ramalexiev/FireNet/BOMs/Updated Colective BOM.xlsx

Sheet: Main Platform - Revision 1
Comment | Designator | Quantity | Extras | Price per unit | Total Price
CR2450 | BAT1 | 1 | 1 | 1.25 | 2.5
CL21A475KACLRNC | C1, C24 | 2 | 3 | 0.35 | 1.75
885012106022 | C2, C7, C13, C14, C15 | 5 | 2 | 0.094 | 0.658
885012206046 | C3, C4, C5, C6, C8, C16, C17, C19, C21, C22, C23, C25, C26, C29, C30, C31, C32, C50 | 18 | 5 | 0.057 | 1.311
GQM1885C2A6R8CB01D | C9, C10 | 2 | 1 | 0.81 | 2.43
GRM1885C1H102JA01J | C12 | 1 | 1 | 0.14 | 0.28
DB-5R5D105T | C18 | 1 | 1 | 5.1 | 10.2
GRM21BR61E106MA73L | C11, C20, C27, C28 | 4 | 1 | 0.38 | 1.9
CC0805JRNPO0BN120 | C33, C34 | 2 | 1 | 0.21 | 0.63
GCM155R71E103KA37D | C35 | 1 | 1 | 0.14 | 0.28
GCM1555C1H470JA16D | C36, C40, C46 | 3 | 1 | 0.14 | 0.56
GCM155R71H102KA37D | C37, C47 | 2 | 1 | 0.15 | 0.45
GJM1555C1H1R2CB01D | C38 | 1 | 1 | 0.17 | 0.34
GCM1555C1H220JA16D | C39 | 1 | 1 | 0.15 | 0.3
GCM1555C1H8R2CA16D | C41, C42 | 2 | 1 | 0.17 | 0.51
GJM1555C1H3R3CB01D | C43, C44, C45, C48, C49 | 5 | 2 | 0.126 | 0.882
5003 | CLK_1, CLK_2, CS_1, CS_2, GND, MISO_1, MISO_2, MOSI_1, MOSI_2, S_VBAT1, SCL1, SDA1, TP2 | 13 | 3 | 0.475 | 7.6
NSP4201MR6T1G | D1 | 1 | 1 | 0.67 | 1.34
TLMO1000-GS08 | D2 | 1 | 1 | 0.79 | 1.58
APHD1608LCGCK | D3 | 1 | 1 | 0.65 | 1.3
TLMS1000-GS08 | D4, D5 | 2 | 1 | 0.74 | 2.22
PMEG2010ER,115 | D6, D7 | 2 | 1 | 0.54 | 1.62
ESDS312DBVR | D8 | 1 | 1 | 0.97 | 1.94
SSW-106-01-T-S | J1 | 1 | 1 | 0.92 | 1.84
1986775-6 | J2 | 1 | 5 | 4.17 | 25.02
5-1814832-1 | J3 | 1 | 5 | 2.82 | 16.92
MA5532 | L1 | 1 | 1 | 2.82 | 5.64 | Order from Mouser
LQW15AN33NJ00D | L2 | 1 | 1 | 0.26 | 0.52
LQW15AN2N7D00D | L3 | 1 | 1 | 0.26 | 0.52
LQW15AN5N6C10D | L4, L5 | 2 | 1 | 0.32 | 0.96
LQG15HS10NJ02D | L6 | 1 | 1 | 0.15 | 0.3
BSD 223P | Q1 | 1 | 1 | 0.67 | 1.34
NTJD5121NT1G | Q2 | 1 | 1 | 0.5 | 1
CRCW060333R0FKEAC | R1, R2, R3, R4, R5, R6, R7, R8, R11, R38 | 10 | 2 | 0.057 | 0.684
RC0603FR-0710KL | R9, R10, R18, R19, R32, R36 | 6 | 2 | 0.036 | 0.288
RC0603FR-0742K2L | R12 | 1 | 1 | 0.15 | 0.3
CR0603-FX-2003ELF | R13 | 1 | 1 | 0.15 | 0.3
RT0603FRE07220KL | R14 | 1 | 1 | 0.15 | 0.3
RC0603FR-07100KL | R15, R20, R23, R30, R31 | 5 | 2 | 0.036 | 0.252
ERJ-3EKF4701V | R16, R17 | 2 | 2 | 0.15 | 0.6
ERJ-3EKF9090V | R21, R22, R26 | 3 | 1 | 0.15 | 0.6
ERJ-3GEYJ132V | R24, R25, R28, R29, R34, R37 | 6 | 2 | 0.1 | 0.8
ERJ-3EKF6190V | R27 | 1 | 1 | 0.15 | 0.3
HRG3216Q-30R0-D-T1 | R33 | 1 | 1 | 1.46 | 2.92
RC0603FR-0720KL | R35 | 1 | 1 | 0.15 | 0.3
CRCW04020000Z0EDC | R39 | 1 | 1 | 0.15 | 0.3
ESR03EZPJ102 | R40 | 1 | 1 | 0.15 | 0.3
NTCG164KF104FTDS | RT1 | 1 | 1 | 0.43 | 0.86
STM32L433CCT6 | U1 | 1 | 1 | 8.83 | 17.66
AS3935 | U2 | 1 | 1 | 15.9 | 31.8
TS881ILT | U3 | 1 | 1 | 1.15 | 2.3
LM4120IM5-3.0/NOPB | U4 | 1 | 1 | 2.82 | 5.64
MAX9938WEUK+ | U5 | 1 | 1 | 2.28 | 4.56
MIC2041 | U6 | 1 | 1 | 1.93 | 3.86
SX1272IMLTRT | U7 | 1 | 1 | 11.41 | 22.82
MASWSS0166TR-3000 | U8 | 1 | 1 | 1.59 | 3.18
SF2098E | U9 | 1 | 1 | 1.84 | 3.68
NX3215SA-32.768K | Y1 | 1 | 1 | 1.03 | 2.06
ECS-320-10-30B-CKM-TR | Y2 | 1 | 1 | 0.94 | 1.88
971150611 | Standoff | 4 | 1
Totals: | Passives | 33.885 |  | Overall Price | 205.185
 | Special Components | 106.53 |  | Savings | 73.74
 | Ics | 129.75 |  | Paying Price | 131.445

Sheet: Sensor Board - Revision 1
Comment | Quantity | Extras | Price per Unit | Total Price | Designator
885012206046 | 3 | 2 | 0.057 | 0.285 | C1, C3, C4
885012106022 | 2 | 2 | 0.094 | 0.376 | C2, C5
CL21A475KACLRNC | 1 | 1 | 0.35 | 0.7 | C6
NSP4201MR6T1G | 1 | 0 | 0.67 | 0.67 | D1
5003 | 4 | 1 | 0.475 | 2.375 | GND1, S_SCL1, S_SDA1, VBAT1
T4111002041-000 | 1 | 4 | 5.39 | 26.95
T4141012041-000 | 1 | 4 | 8.58 | 42.9 | J1
NTJD5121NT1G | 1 | 1 | 0.53 | 1.06 | Q1
CRCW060333R0FKEAC | 2 | 1 | 0.15 | 0.45 | R1, R3
ERJ-3EKF4701V | 3 | 1 | 0.15 | 0.6 | R2, R4, R6
RC0603FR-0710KL | 1 | 1 | 0.15 | 0.3 | R5
SGP30 | 1 | 1 | 20.49 | 40.98 | U1
CCS811 | 1 | 3 | 19.44 | 77.76 | U2
BME280 | 1 | 1 | 11.81 | 23.62 | U3
AP2138N-1.8TRG1 | 1 | 1 | 0.53 | 1.06 | U4
 |  | Total Expected Price: |  |  | 220.086
 |  | Sponsorships: |  |  | 147.61
 |  | Removal of SGP30: |  |  | 44.15
 |  | Total Paying Price: |  |  | 28.326

Sheet: Total - Revision 1
Total Component expected costs: | 387.083
Total sponsorship savings: | 182.474
Total gas sensor savings: | 44.15
Total paying price: | 160.463
