ramalexiev/FireNet/BOMs/FireNet Pod - Altium.xlsx

Comment | Designator | Quantity
CL21A475KACLRNC | C1, C20 | 2
885012106022 | C2, C7, C13, C14, C15, C47, C50 | 7
885012206046 | C3, C4, C5, C6, C8, C16, C17, C18, C21, C22, C25, C26, C27, C28, C46, C48, C49 | 17
GQM1885C2A6R8CB01D | C9, C10, C29, C30 | 4
GRM21BR61E106MA73L | C11, C19, C23, C24 | 4
GRM1885C1H102JA01J | C12 | 1
GCM155R71H102KA37D | C31, C41 | 2
GCM1555C1H470JA16D | C32, C33, C39 | 3
GJM1555C1H3R3CB01D | C34, C35, C36, C37, C45 | 5
GCM155R71E103KA37D | C38 | 1
GJM1555C1H1R2CB01D | C40 | 1
GCM1555C1H220JA16D | C42 | 1
GCM1555C1H8R2CA16D | C43, C44 | 2
NSP4201MR6T1G | D1, D7 | 2
TLMO1000-GS08 | D2 | 1
APHD1608LCGCK | D3 | 1
TLMS1000-GS08 | D4, D5 | 2
DDZ3V6BSF-7DICT-ND | D6 | 1
SSW-106-01-T-S | J1 | 1
T4141012041-000 | J2 | 1
100uH | L1 | 1
LQG15HS10NJ02D | L2 | 1
LQW15AN33NJ00D | L3 | 1
LQW15AN2N7D00D | L4 | 1
LQW15AN5N6C10D | L5, L6 | 2
BSD 223P | Q1 | 1
NTJD5121NT1G | Q2, Q3 | 2
CRCW060333R0FKEAC | R1, R2, R3, R4, R5, R6, R7, R8, R11, R24, R25, R28, R29, R36, R40, R42 | 16
A126331CT-ND | R9, R10, R18, R19, R20, R23, R30, R31, R32, R34, R41, R43 | 12
RC0603FR-0742K2L | R12 | 1
CR0603-FX-2003ELF | R13 | 1
RT0603FRE07220KL | R14 | 1
ERA-3AEB104V | R15 | 1
ERJ-3EKF4701V | R16, R17 | 2
ERJ-3EKF9090V | R21, R22, R26 | 3
ERJ-3EKF6190V | R27 | 1
RC0603FR-0720KL | R33 | 1
ERJ-3GEYJ132V | R35 | 1
CRCW04020000Z0EDC | R37, R38 | 2
ESR03EZPJ102 | R39 | 1
NTCG164KF104FTDS | RT1 | 1
5003 | TP1, TP2, TP3, TP4, TP5, TP6, TP7, TP8, TP9, TP10, TP11, TP12, TP13, TP14, TP15, TP16, TP17, TP18, TP19, TP20, TP21, TP22 | 22
STM32L433CCT6 | U1 | 1
AS3935 | U2 | 1
TS881ILT | U3 | 1
LM4120IM5-3.0/NOPB | U4 | 1
MIC2041 | U5 | 1
SX1272IMLTRT | U6 | 1
PE4259-63 | U7 | 1
SGP30 | U8 | 1
BME280 | U9 | 1
AP2138N-1.8TRG1 | U10 | 1
NX3215SA-32.768K | Y1 | 1
FA-20H 32.0000MF12Y-W3 | Y2 | 1
