ramalexiev/FireNet/3D Parts/Mass-Damper-Block-Mass-With-Mounting-Holes.DXF

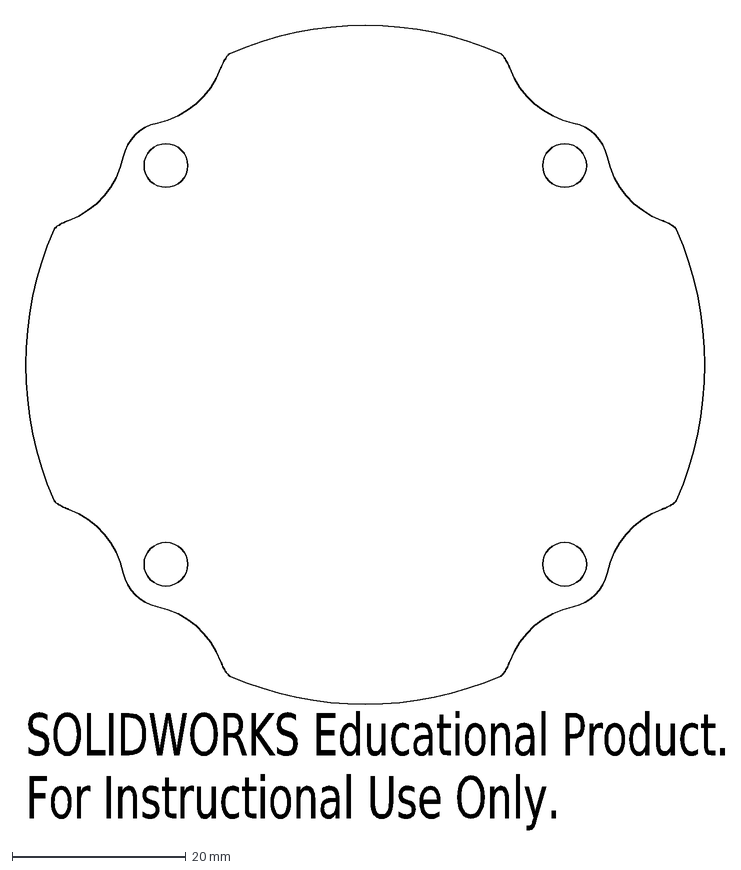
[picture p1: CAD file, 2019-02-22]
3D Parts/Mass-Damper-Block-Mass-With-Mounting-Holes.DXF
SOLIDWORKS Educational Product.
For Instructional Use Only.
