ramalexiev/FireNet/3D Parts/R1_Sensor Board - no fasteners.step

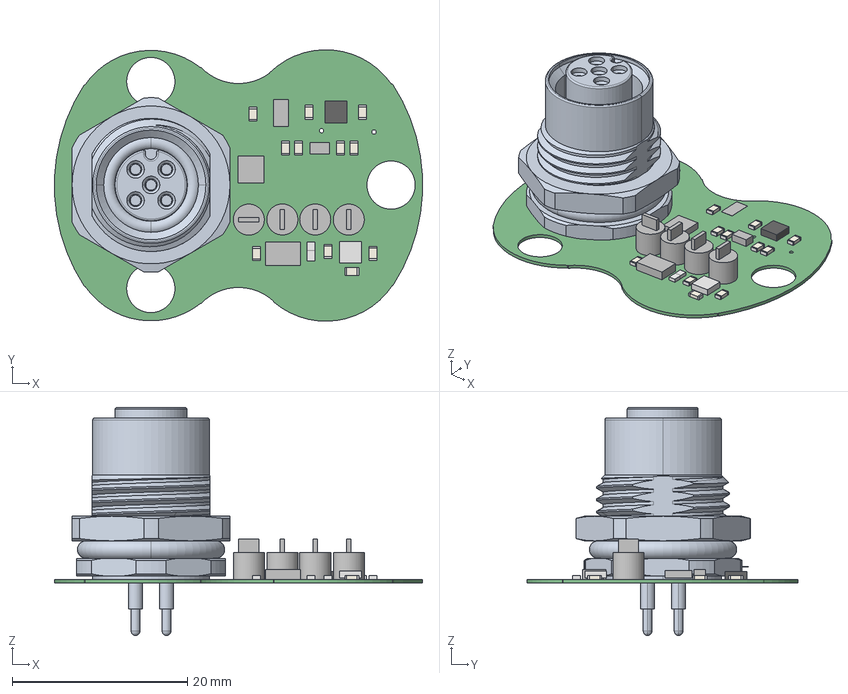
[picture p2: CAD file, 2019-02-22]
3D Parts/R1_Sensor Board - no fasteners.step
42.0 x 30.9 x 26.0 mm
B3
B2
B1
Extruded x 46
c-t4141012041-000-a-3d
