ramalexiev/FireNet/3D Parts/c-t4141012041-000-a-3d.stp

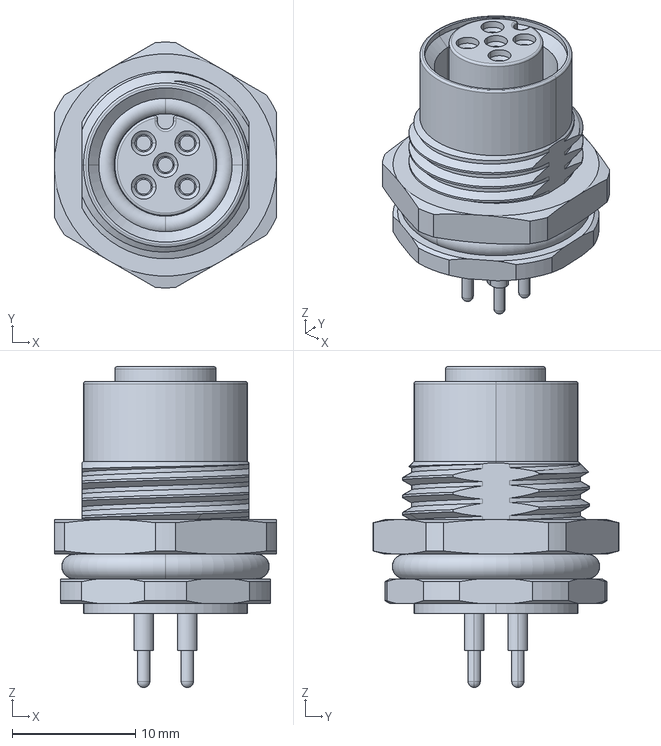
[picture p3: CAD file, 2019-02-22]
3D Parts/c-t4141012041-000-a-3d.stp
18.0 x 19.9 x 26.0 mm
