ramalexiev/FireNet/3D Parts/Space-Claim-Sensor-Board-With-Thru-Holes.STEP

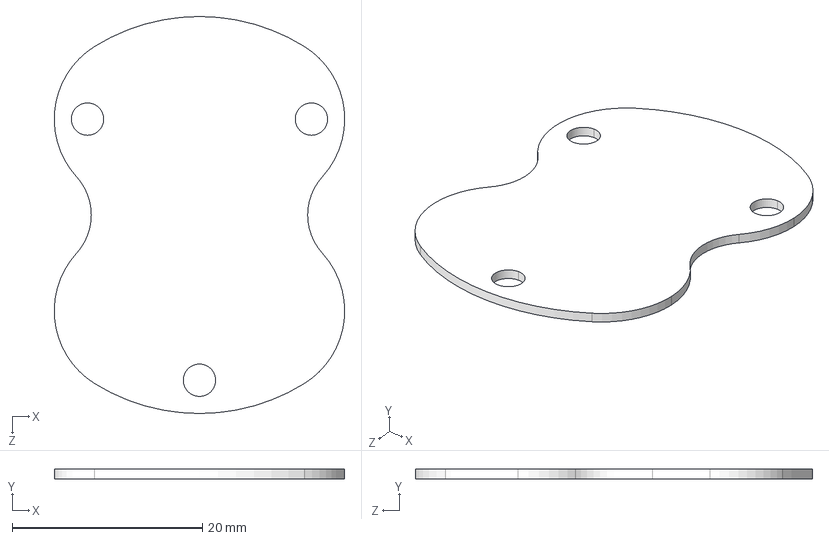
[picture p4: CAD file, 2019-02-22]
3D Parts/Space-Claim-Sensor-Board-With-Thru-Holes.STEP
30.5 x 1.00 x 41.8 mm
