ramalexiev/FireNet/3D Parts/Mass-Damper-Block-Mass-With-Mounting-Holes-2mm-Slice.STEP

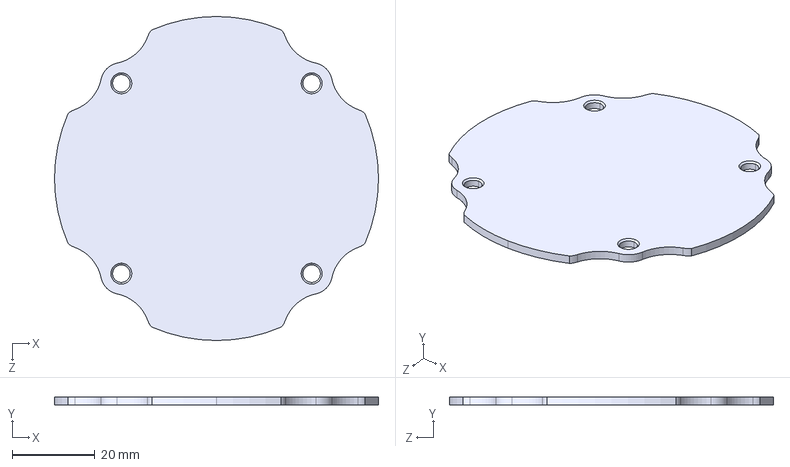
[picture p5: CAD file, 2019-02-22]
3D Parts/Mass-Damper-Block-Mass-With-Mounting-Holes-2mm-Slice.STEP
78.3 x 2.00 x 78.3 mm
