ramalexiev/FireNet/3D Parts/c-5-1814832-1-b-3d.stp

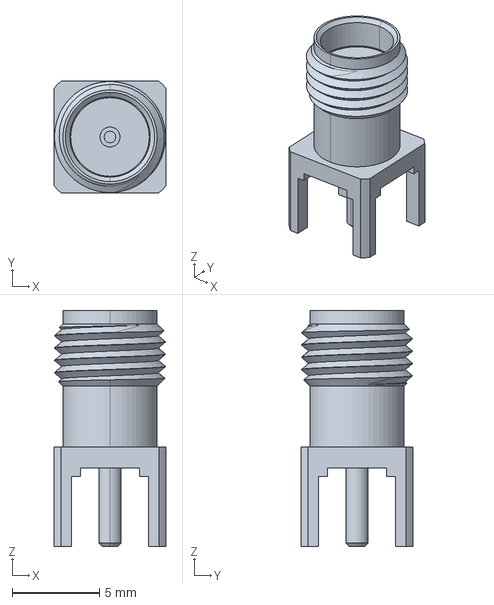
[picture p6: CAD file, 2019-02-22]
3D Parts/c-5-1814832-1-b-3d.stp
6.40 x 6.40 x 13.5 mm
