ramalexiev/FireNet/3D Parts/Sensor-Board-Dimensions.DXF

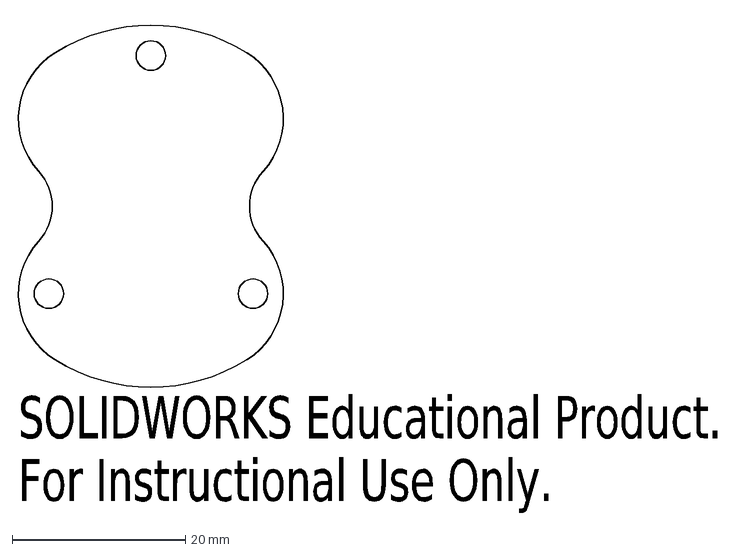
[picture p7: CAD file, 2019-02-22]
3D Parts/Sensor-Board-Dimensions.DXF
SOLIDWORKS Educational Product.
For Instructional Use Only.
