ramalexiev/FireNet/3D Parts/R1_EmberNet Pod Layout - No fasteners.step

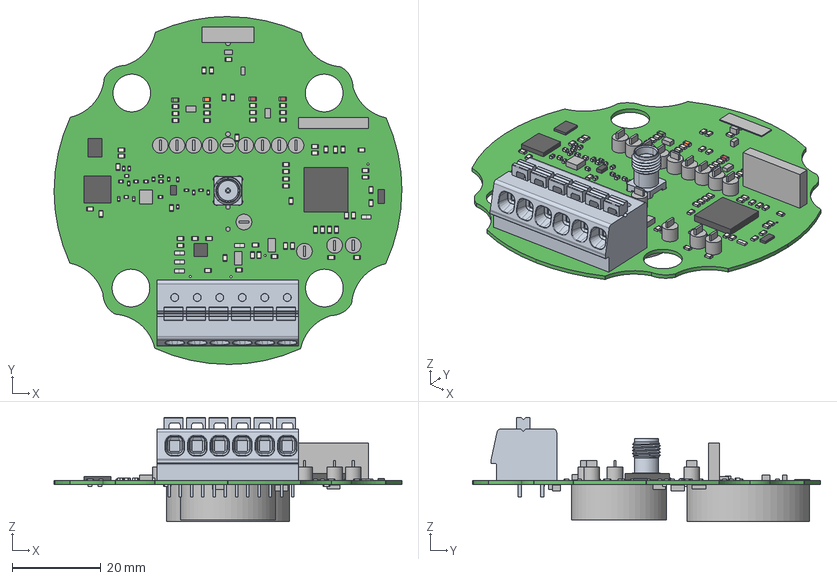
[picture p8: CAD file, 2019-02-22]
3D Parts/R1_EmberNet Pod Layout - No fasteners.step
78.5 x 78.5 x 23.6 mm
Extruded x 322
c-5-1814832-1-b-3d
c-1986775-6-a-3d
