ramalexiev/FireNet/3D Parts/R1_EmberNet Pod Layout.step

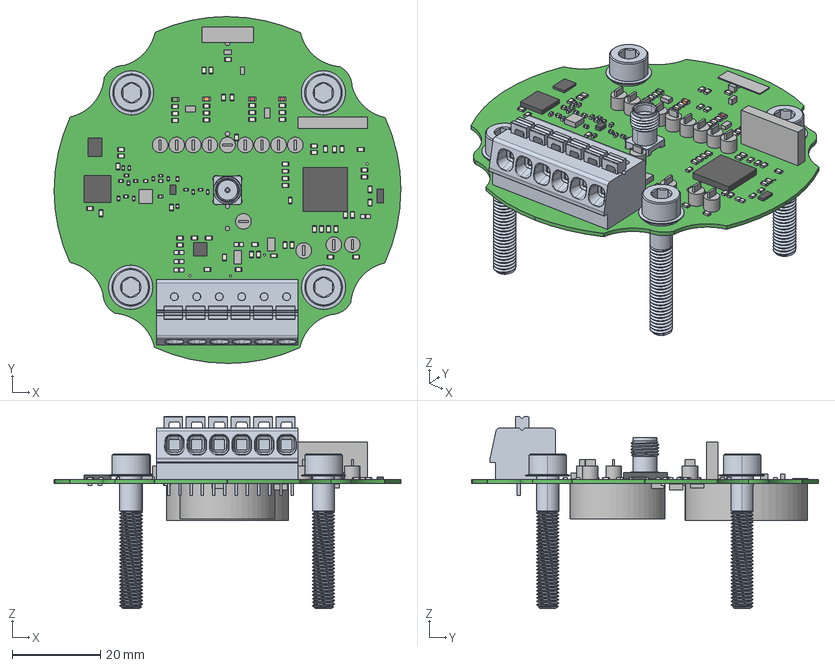
[picture p9: CAD file, 2019-02-22]
3D Parts/R1_EmberNet Pod Layout.step
78.5 x 78.5 x 43.5 mm
96445K204-M5-Belleville-Washer x 4
Extruded x 322
91290A254-M5-SHCS-30mm-Long x 4
c-5-1814832-1-b-3d
c-1986775-6-a-3d
