ramalexiev/FireNet/3D Parts/R1_Sensor Board.step

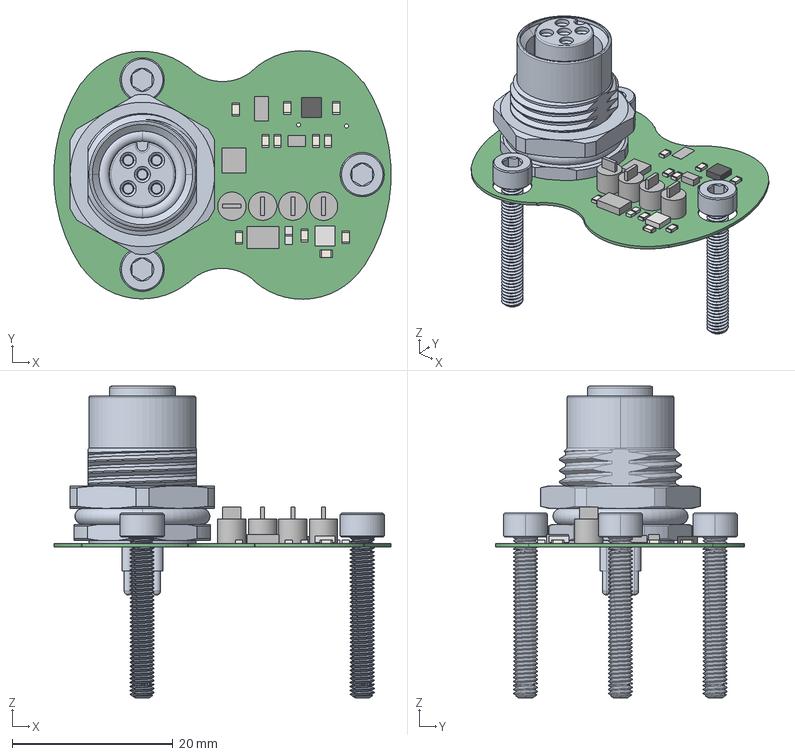
[picture p10: CAD file, 2019-02-22]
3D Parts/R1_Sensor Board.step
42.0 x 30.9 x 38.8 mm
91290A123-M3-SHCS-20mm-Long x 3
Extruded x 46
c-t4141012041-000-a-3d
