ramalexiev/FireNet/3D Parts/c-1986775-6-a-3d.stp

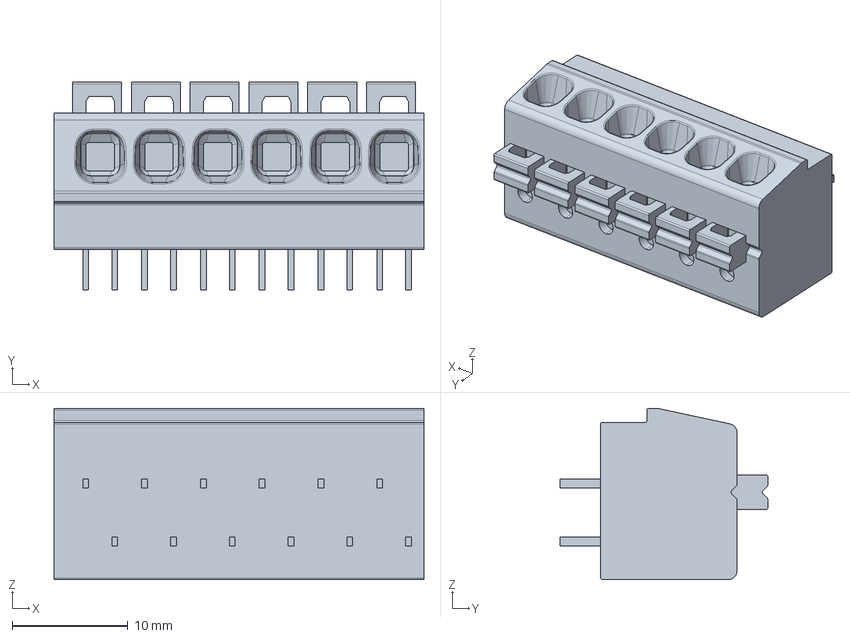
[picture p11: CAD file, 2019-02-22]
3D Parts/c-1986775-6-a-3d.stp
32.0 x 17.9 x 14.8 mm
