ramalexiev/FireNet/3D Parts/91290A254-M5-SHCS-30mm-Long.STEP

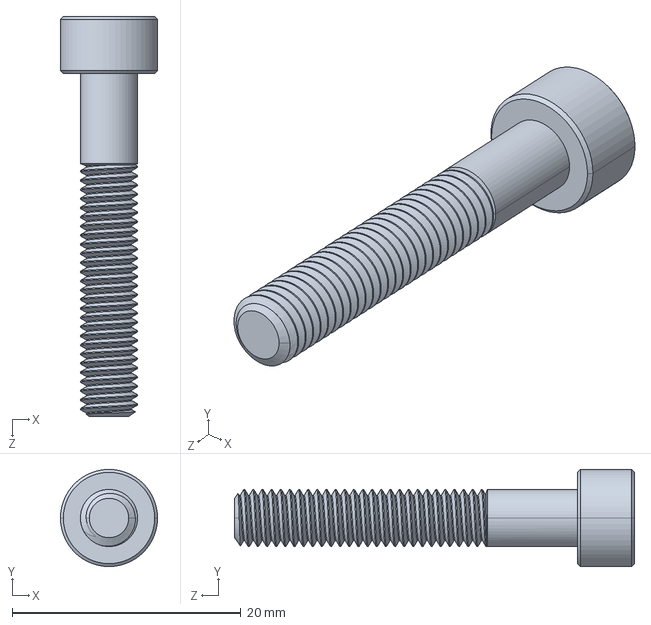
[picture p12: CAD file, 2019-02-22]
3D Parts/91290A254-M5-SHCS-30mm-Long.STEP
8.50 x 8.50 x 35.0 mm
