ramalexiev/FireNet/3D Parts/96445K204-M5-Belleville-Washer.STEP

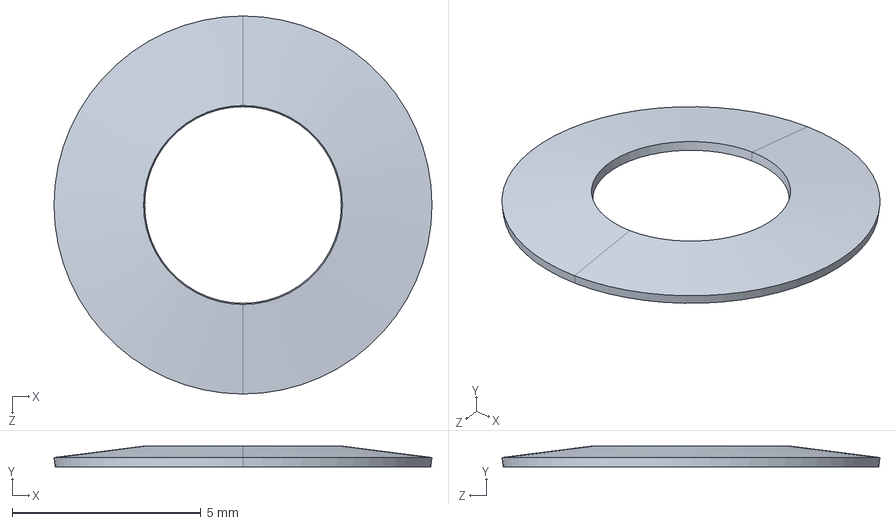
[picture p13: CAD file, 2019-02-22]
3D Parts/96445K204-M5-Belleville-Washer.STEP
10.00 x 0.55 x 10.00 mm
