ramalexiev/FireNet/3D Parts/91290A123-M3-SHCS-20mm-Long.STEP

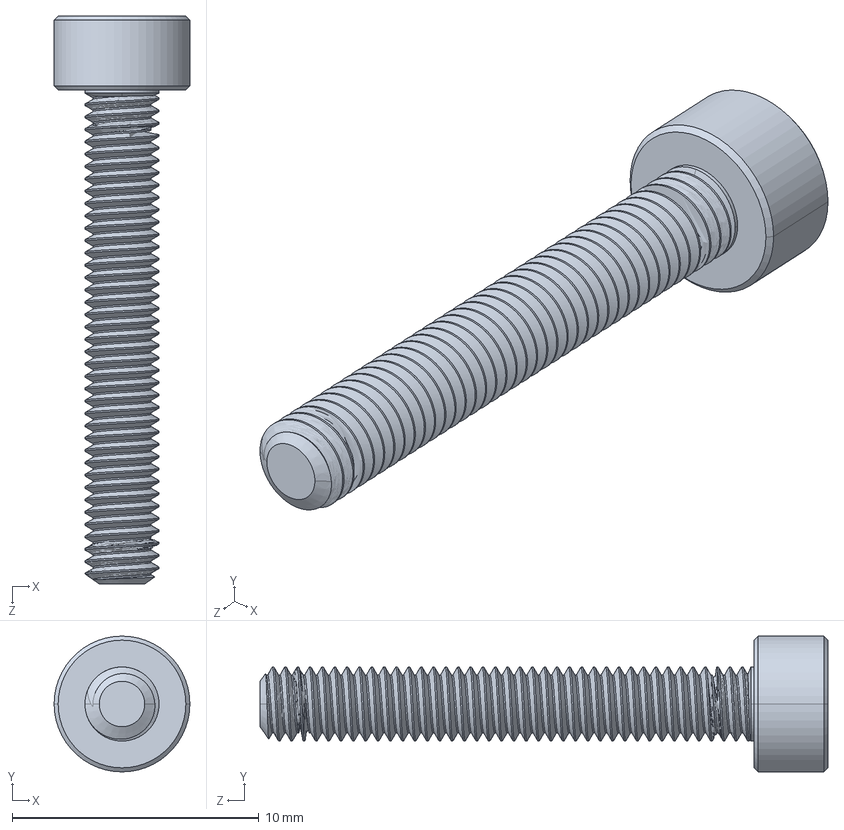
[picture p14: CAD file, 2019-02-22]
3D Parts/91290A123-M3-SHCS-20mm-Long.STEP
5.50 x 5.50 x 23.0 mm
