ramalexiev/FireNet/3D Parts/96445K101-M3-Belleville-Washer.STEP

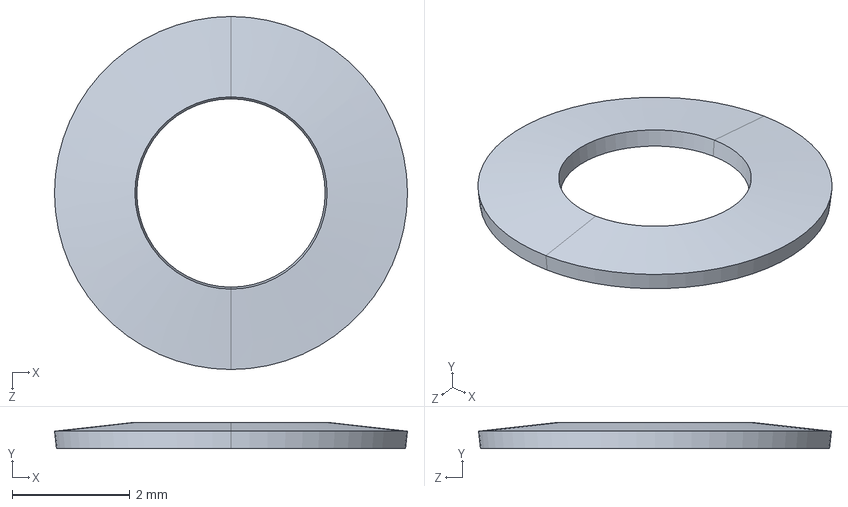
[picture p15: CAD file, 2019-02-22]
3D Parts/96445K101-M3-Belleville-Washer.STEP
6.00 x 0.45 x 6.00 mm
