ramalexiev/FireNet/Simulations/Analog Temperature Sensor/Varying Temperature Sim results - decreasing.pdf

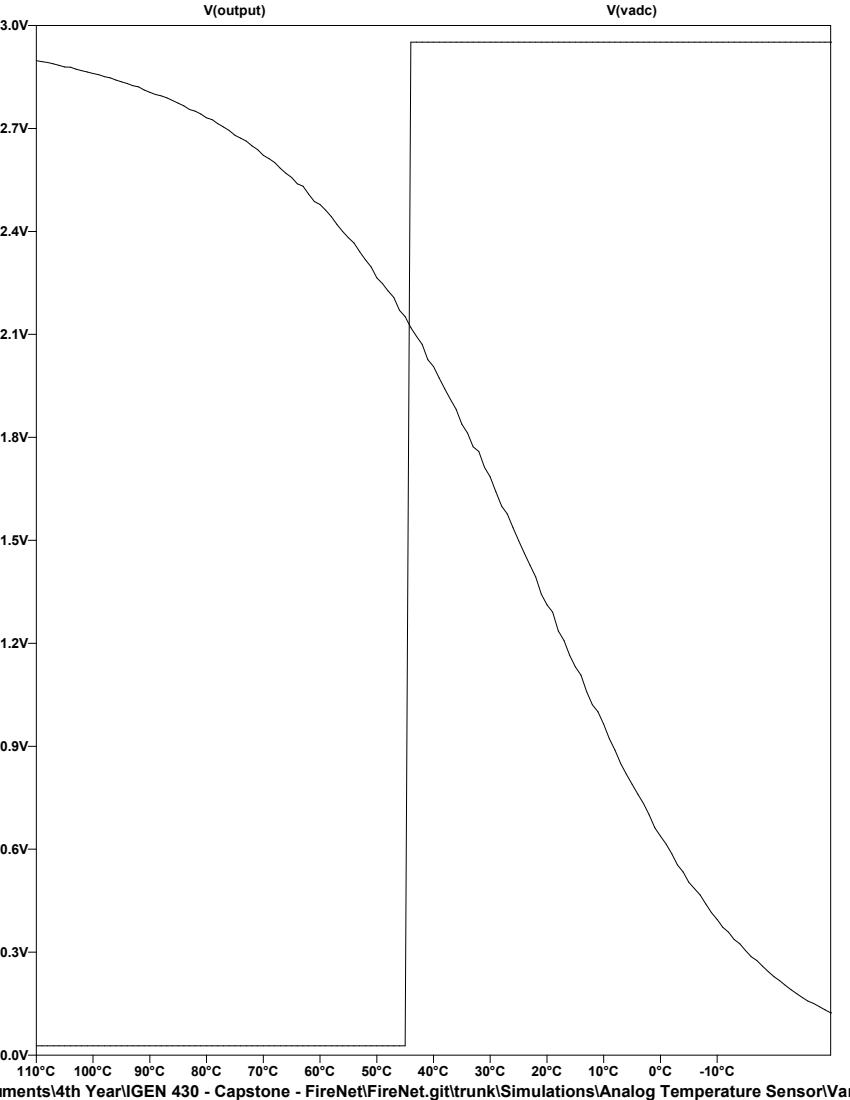
[picture p17: page 1]
V(output); V(vadc)

--- C:\Users\ramal\Documents\4th Year\IGEN 430 - Capstone - FireNet\FireNet.git\trunk\Simulations\Analog Temperature Sensor\Varying Temperature.raw ---
