ramalexiev/FireNet/Simulations/Analog Temperature Sensor/Varying Temperature - Sim results.pdf

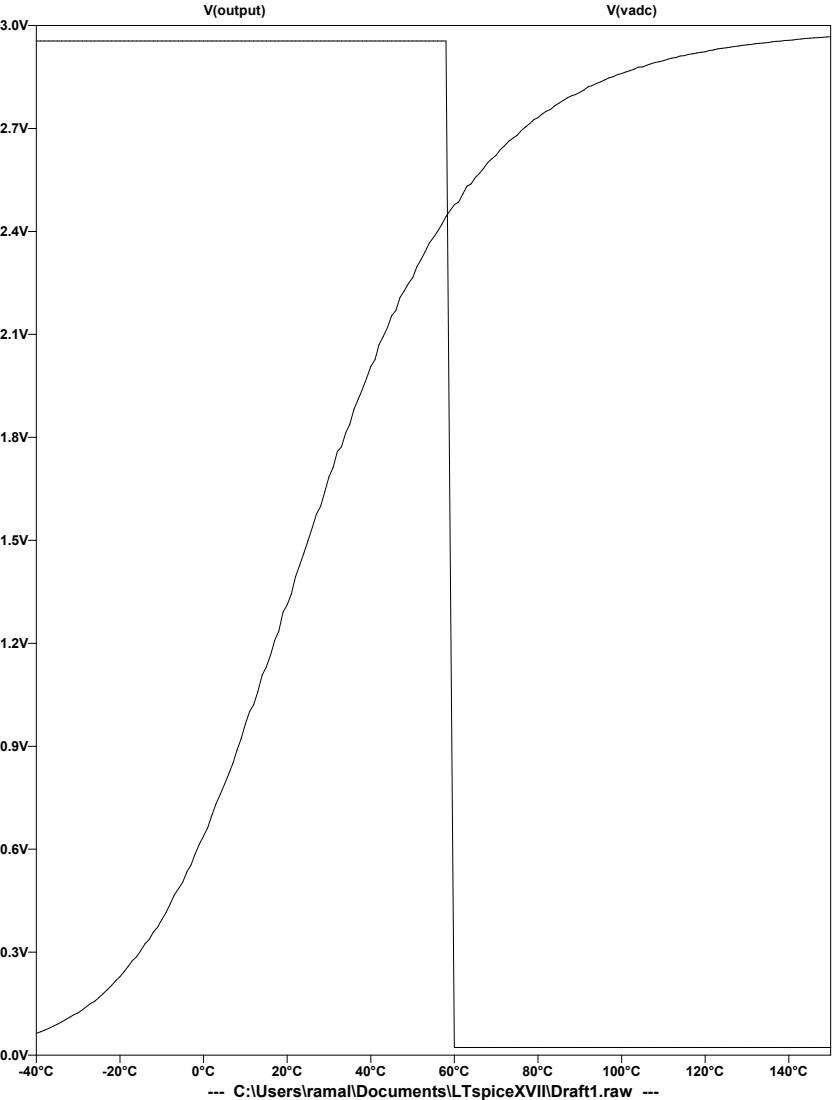
[picture p18: page 1]
V(output); V(vadc)

--- C:\Users\ramal\Documents\LTspiceXVII\Draft1.raw ---
