ramalexiev/FireNet/Sensor Board/Rev1/EmberNet Sensor Board.pdf

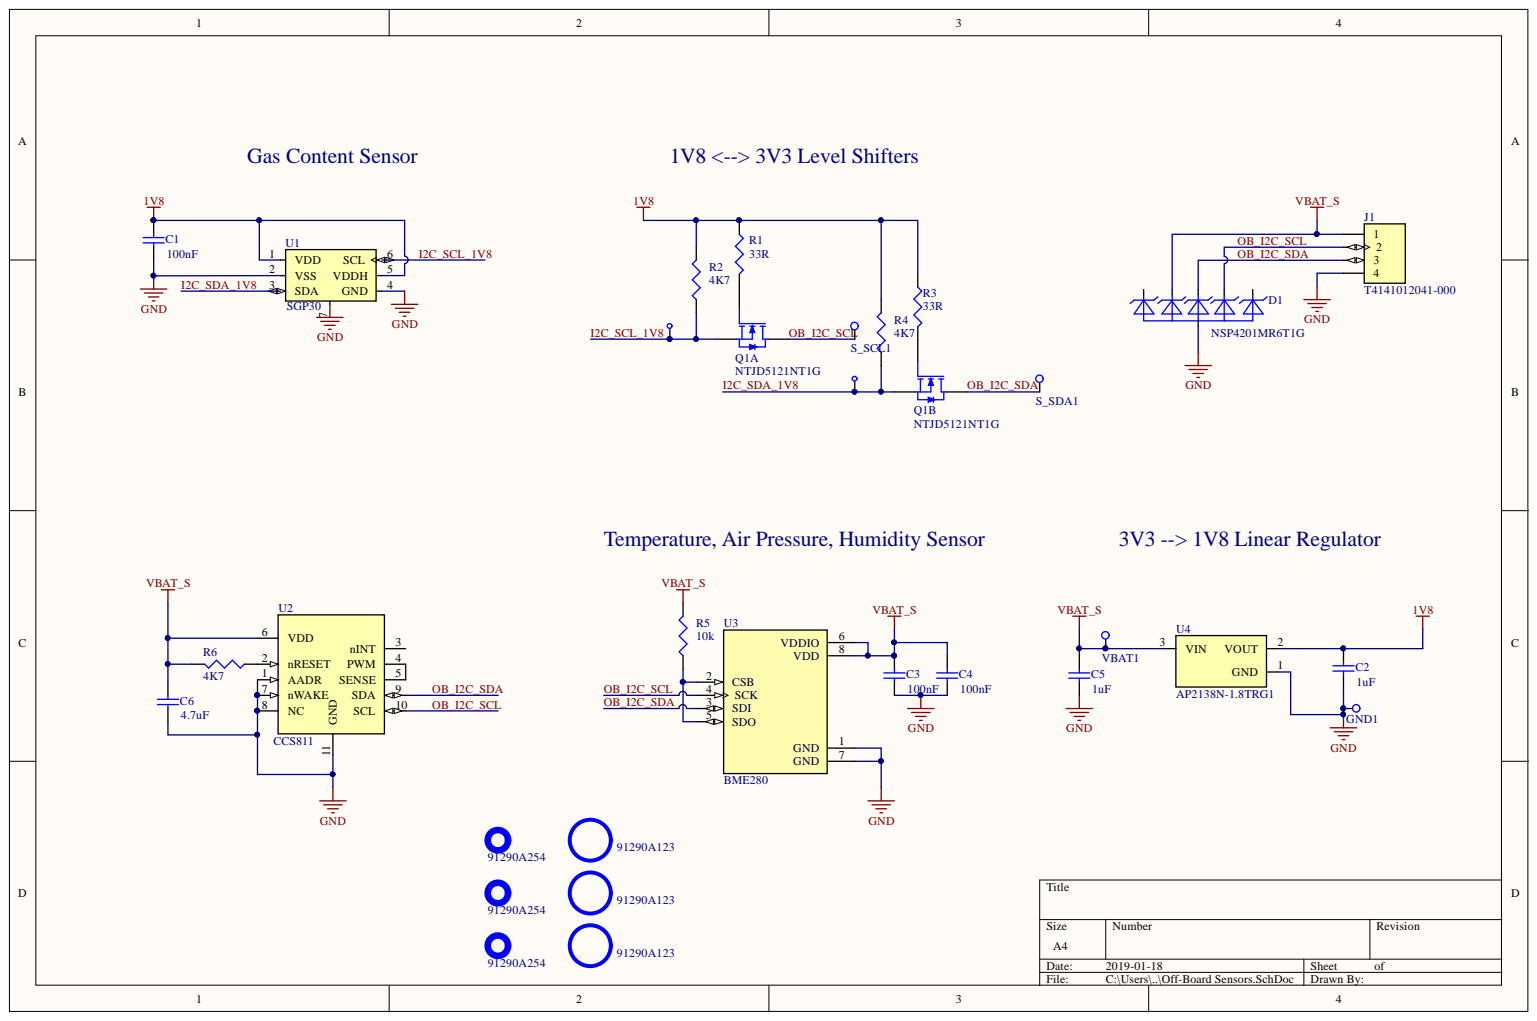
[picture p19: page 1]

Temperature, Air Pressure, Humidity Sensor

# Board Stack Report
