ramalexiev/FireNet/Main Platform/Rev1/FireNet Pod.pdf

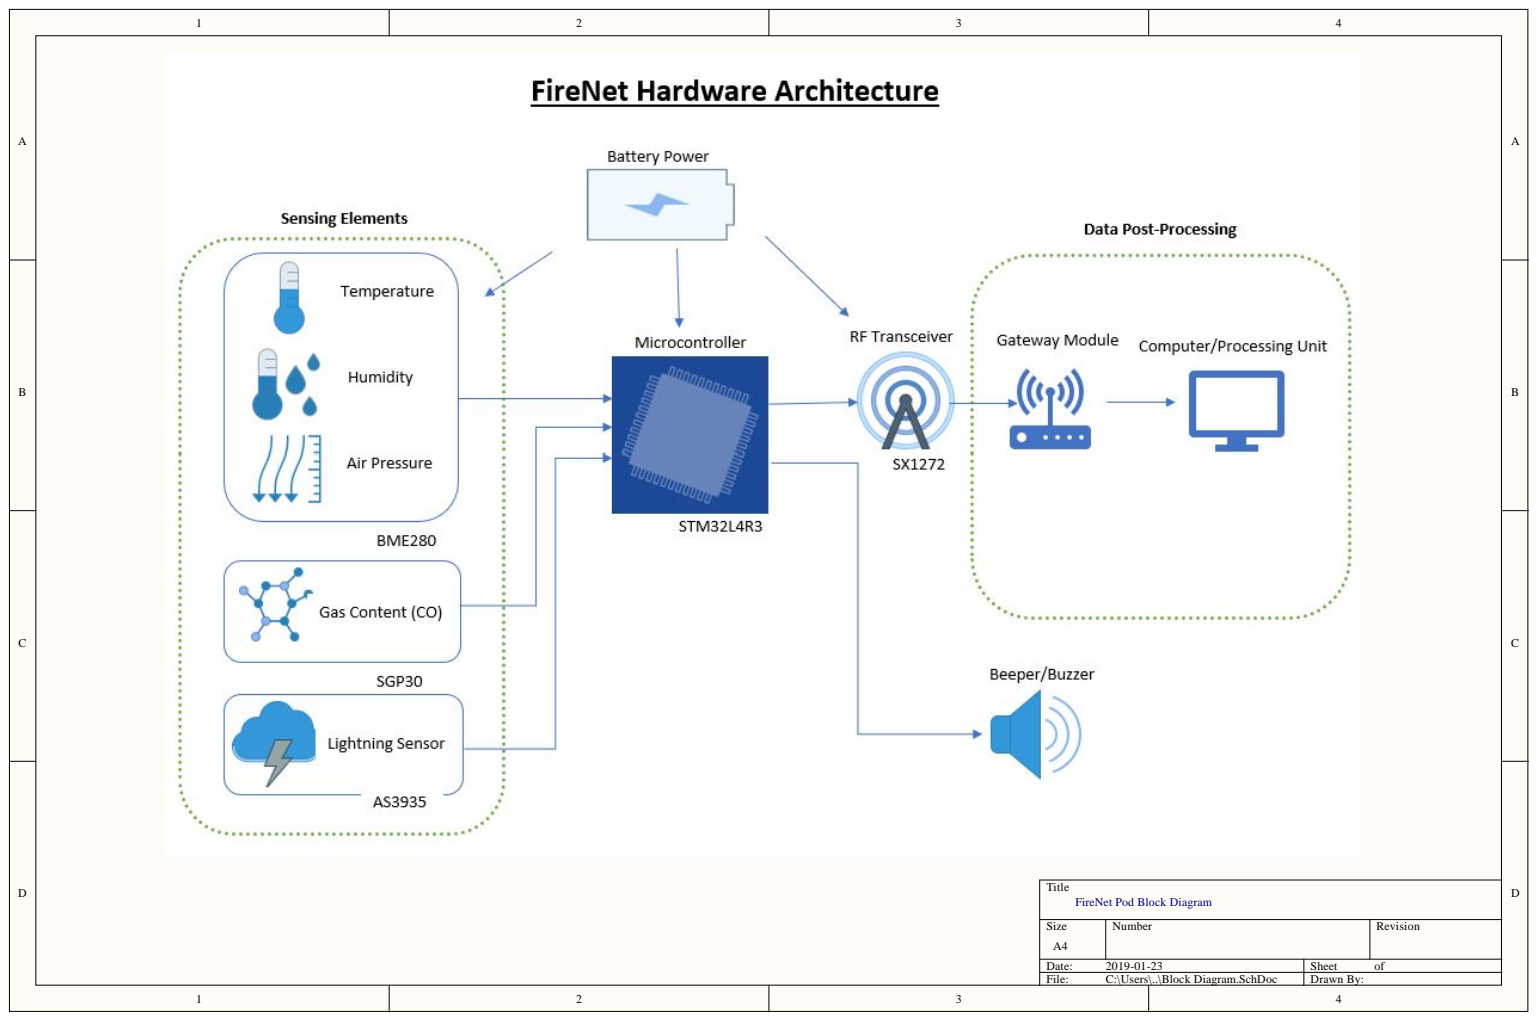
[picture p20: page 1]

Title
FireNet Pod Block Diagram

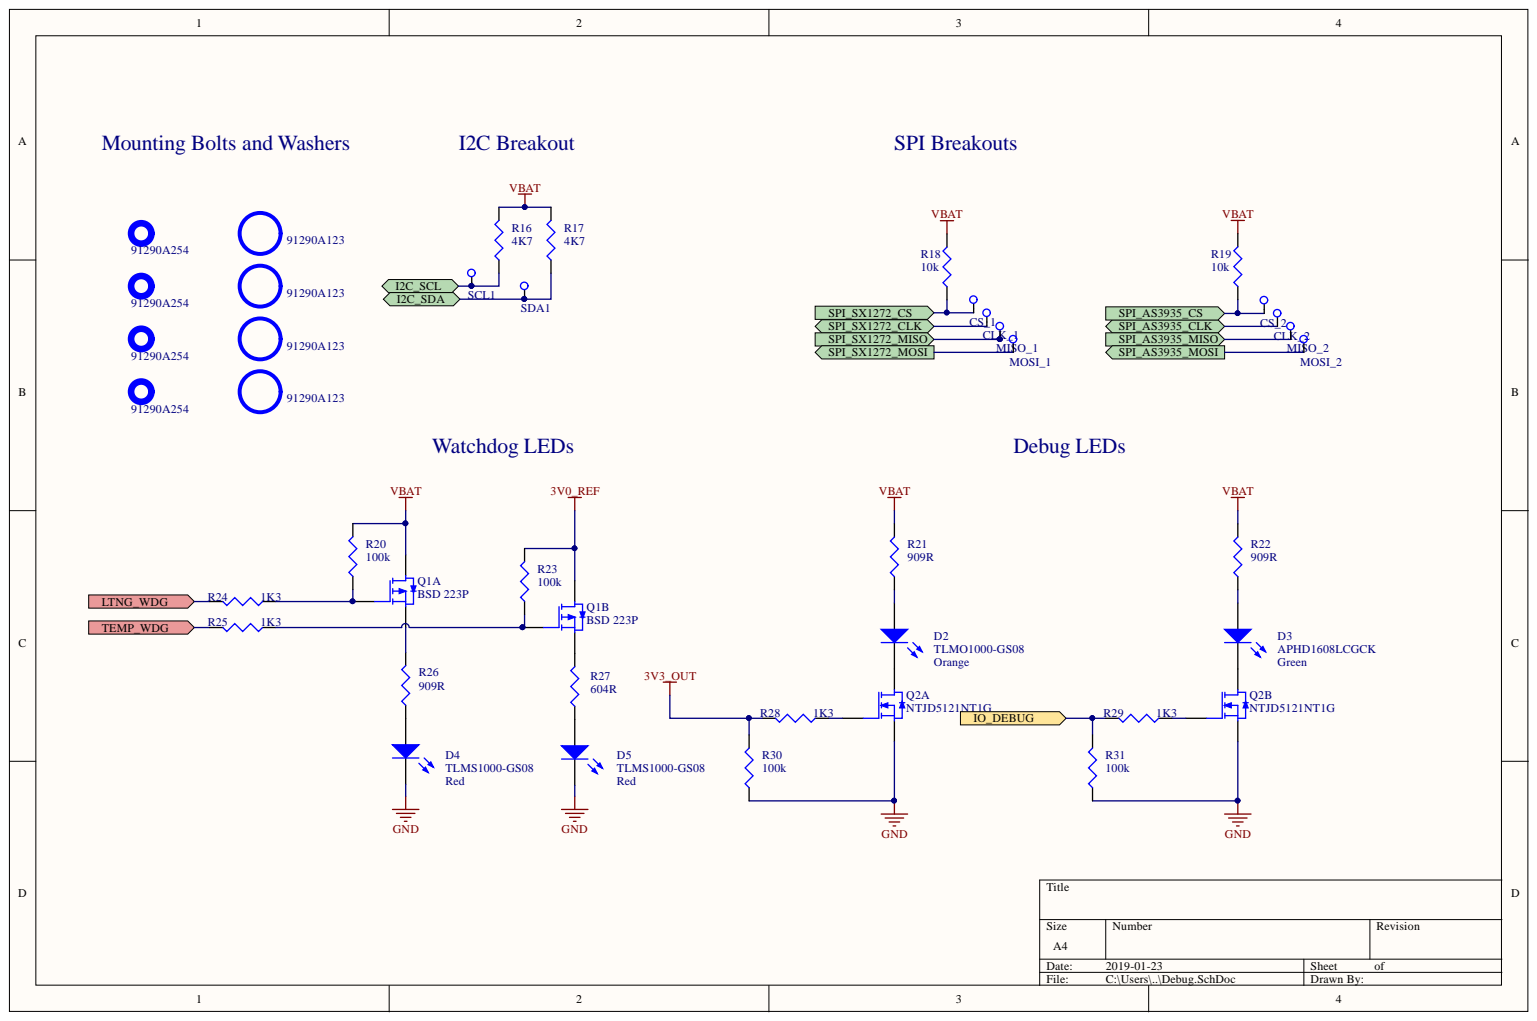
[picture p21: page 2]

Mounting Bolts and Washers

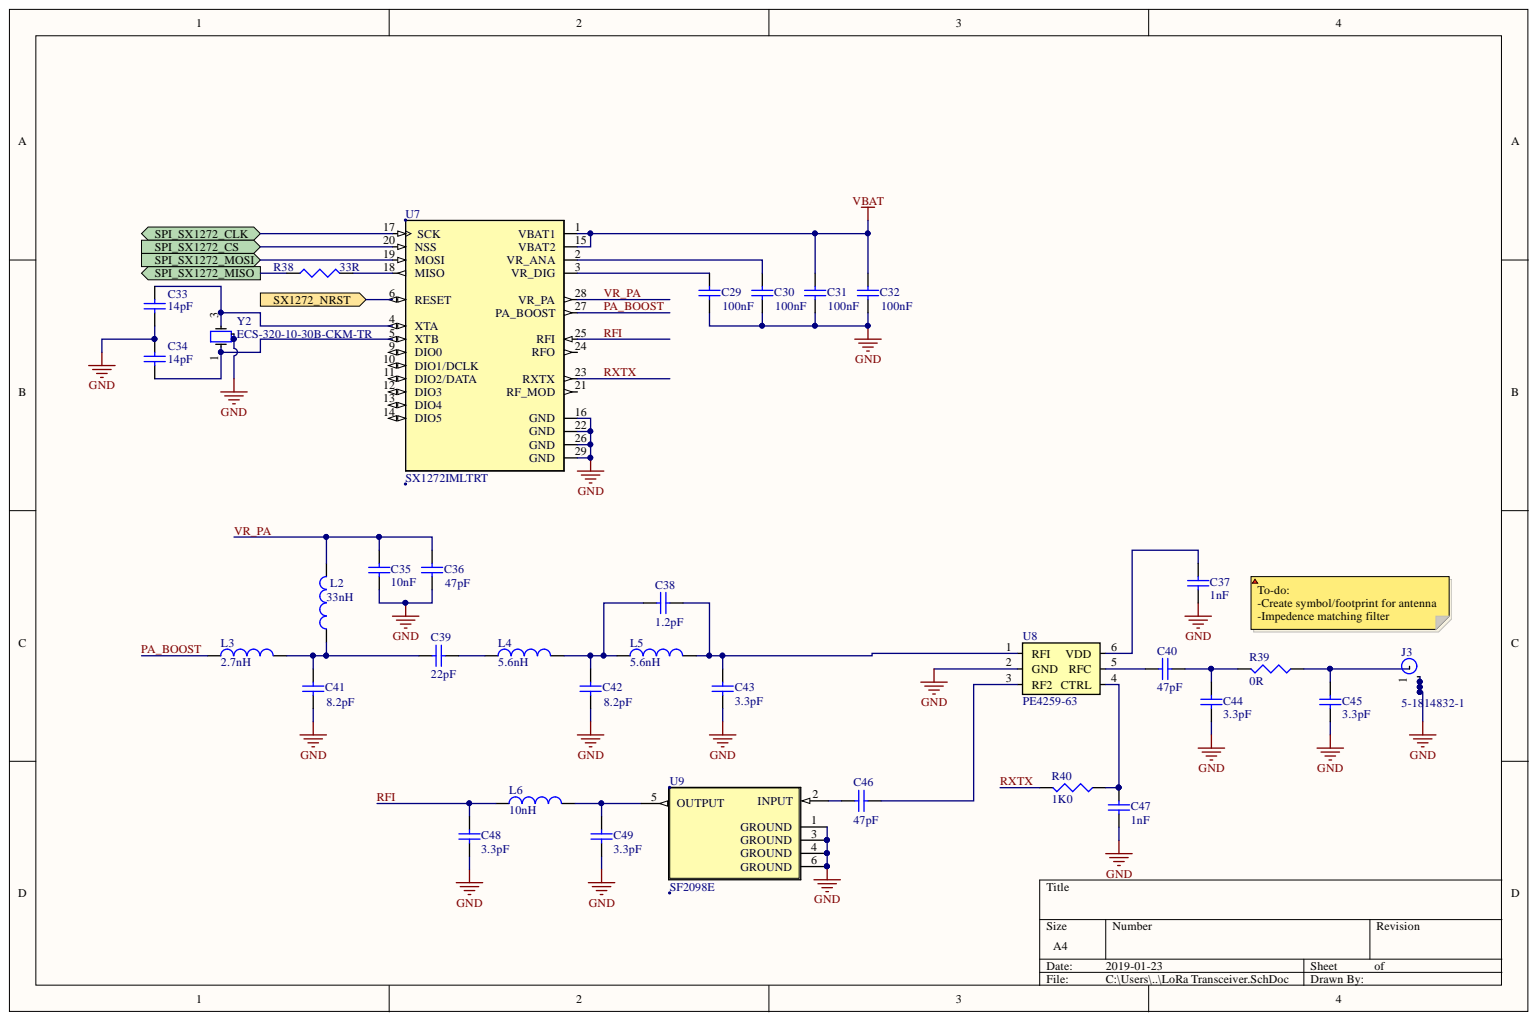
[picture p22: page 3]

-Create symbol/footprint for antenna
-Impedence matching filter

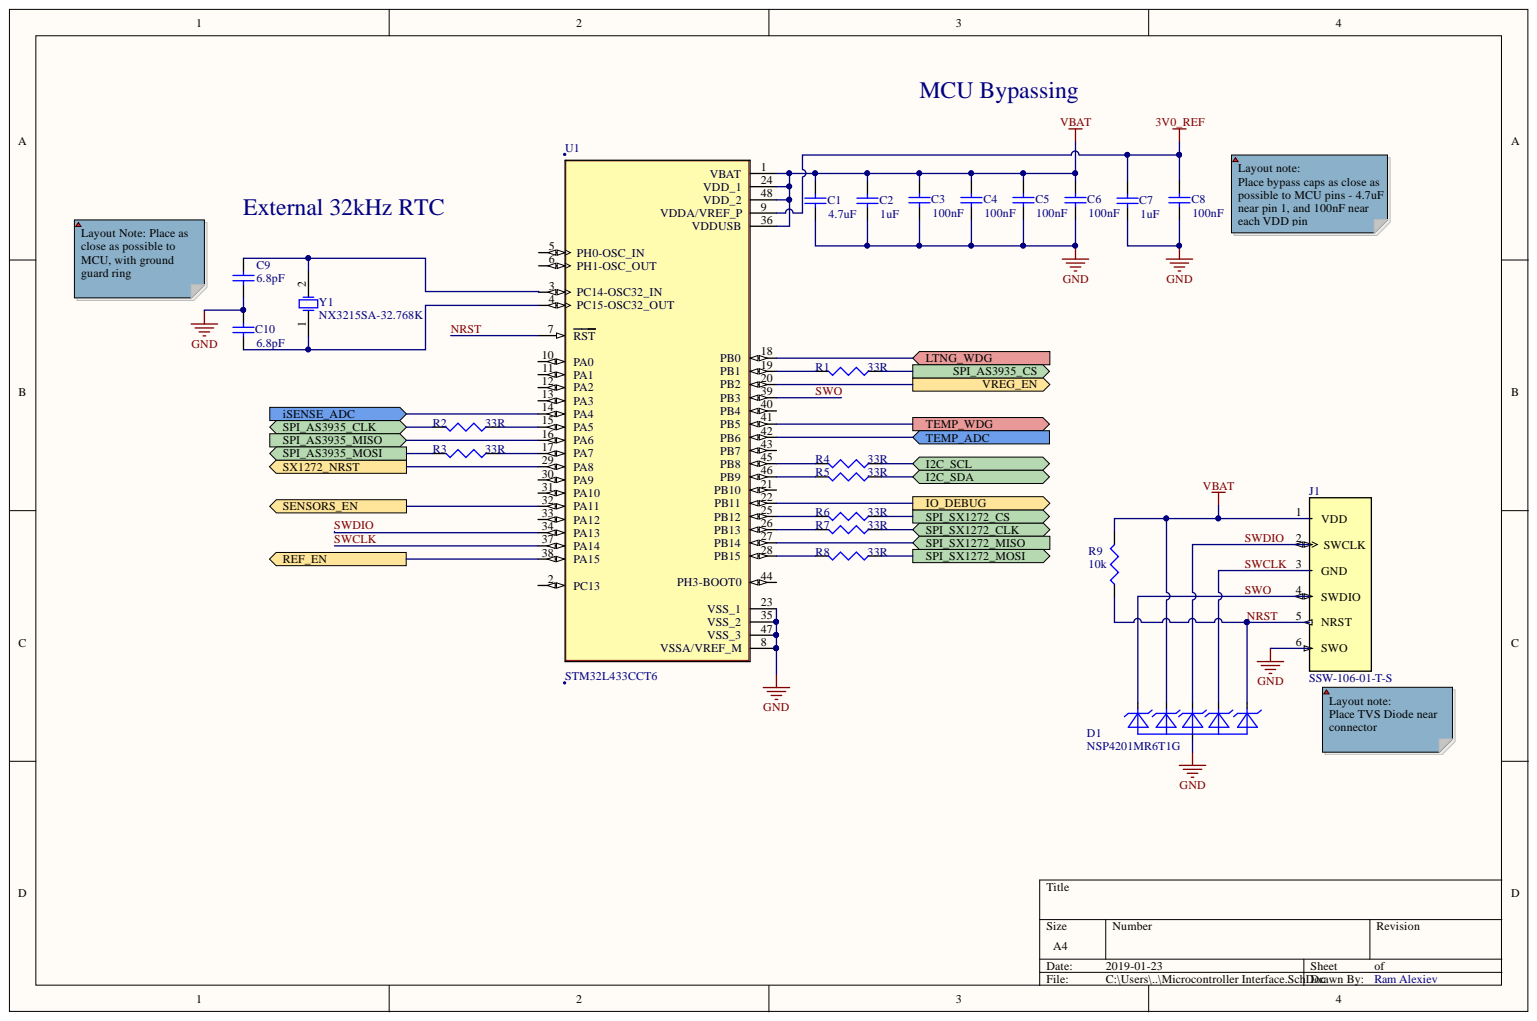
[picture p23: page 4]

2 4
4 8

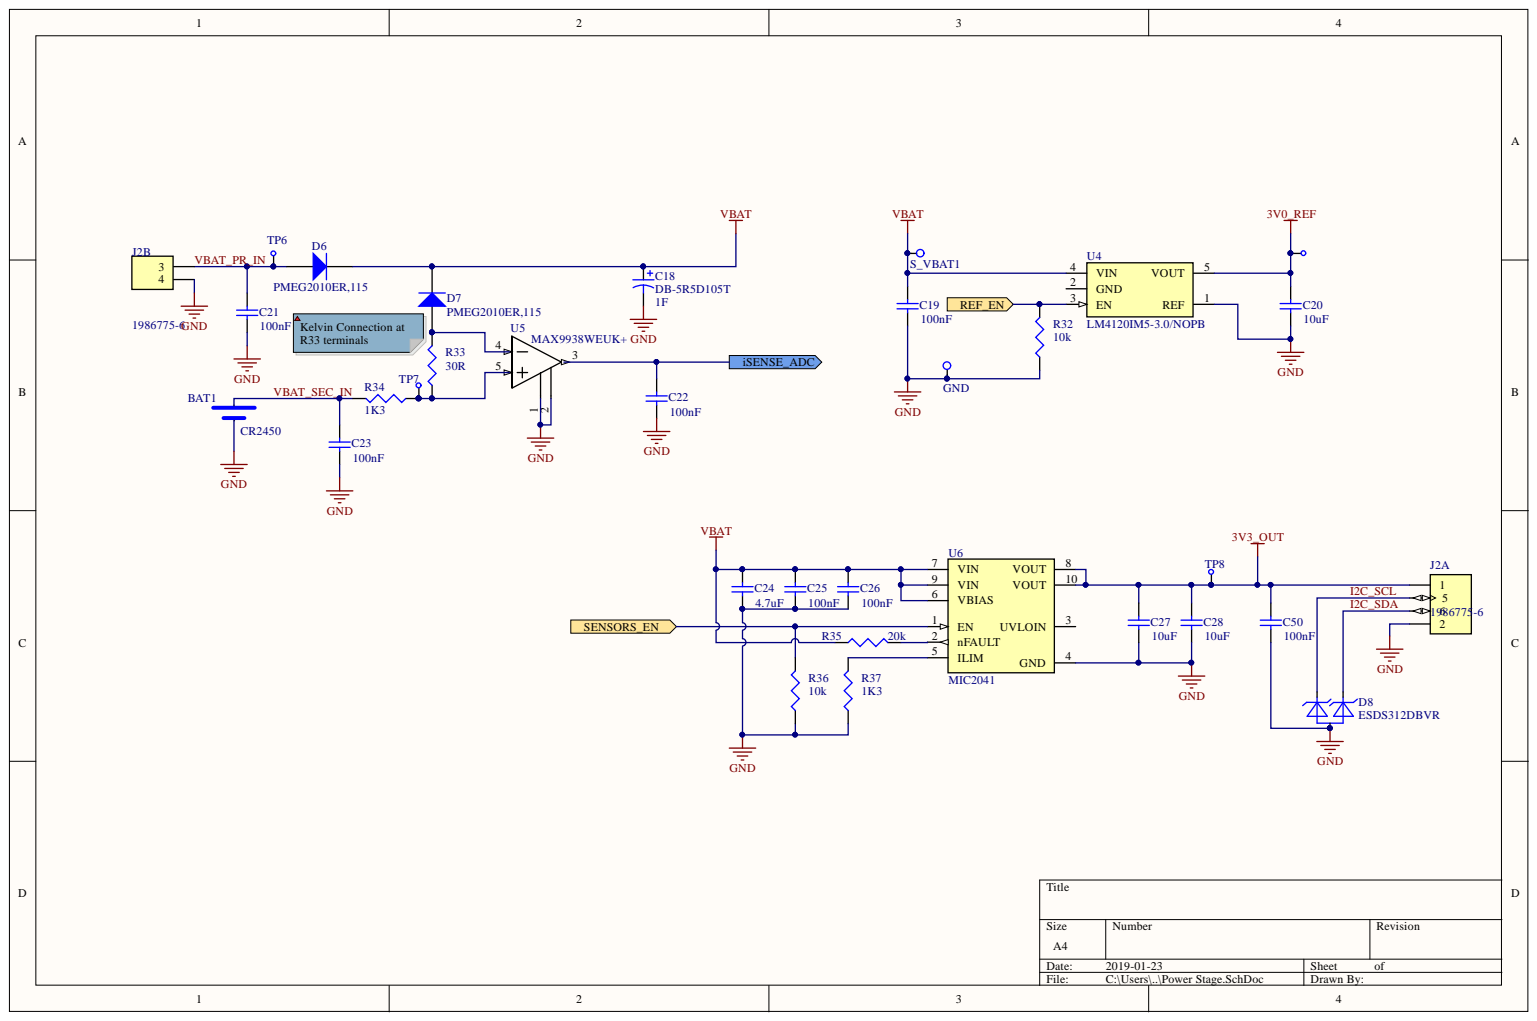
[picture p24: page 5]

VIN 9

I2C_SCL

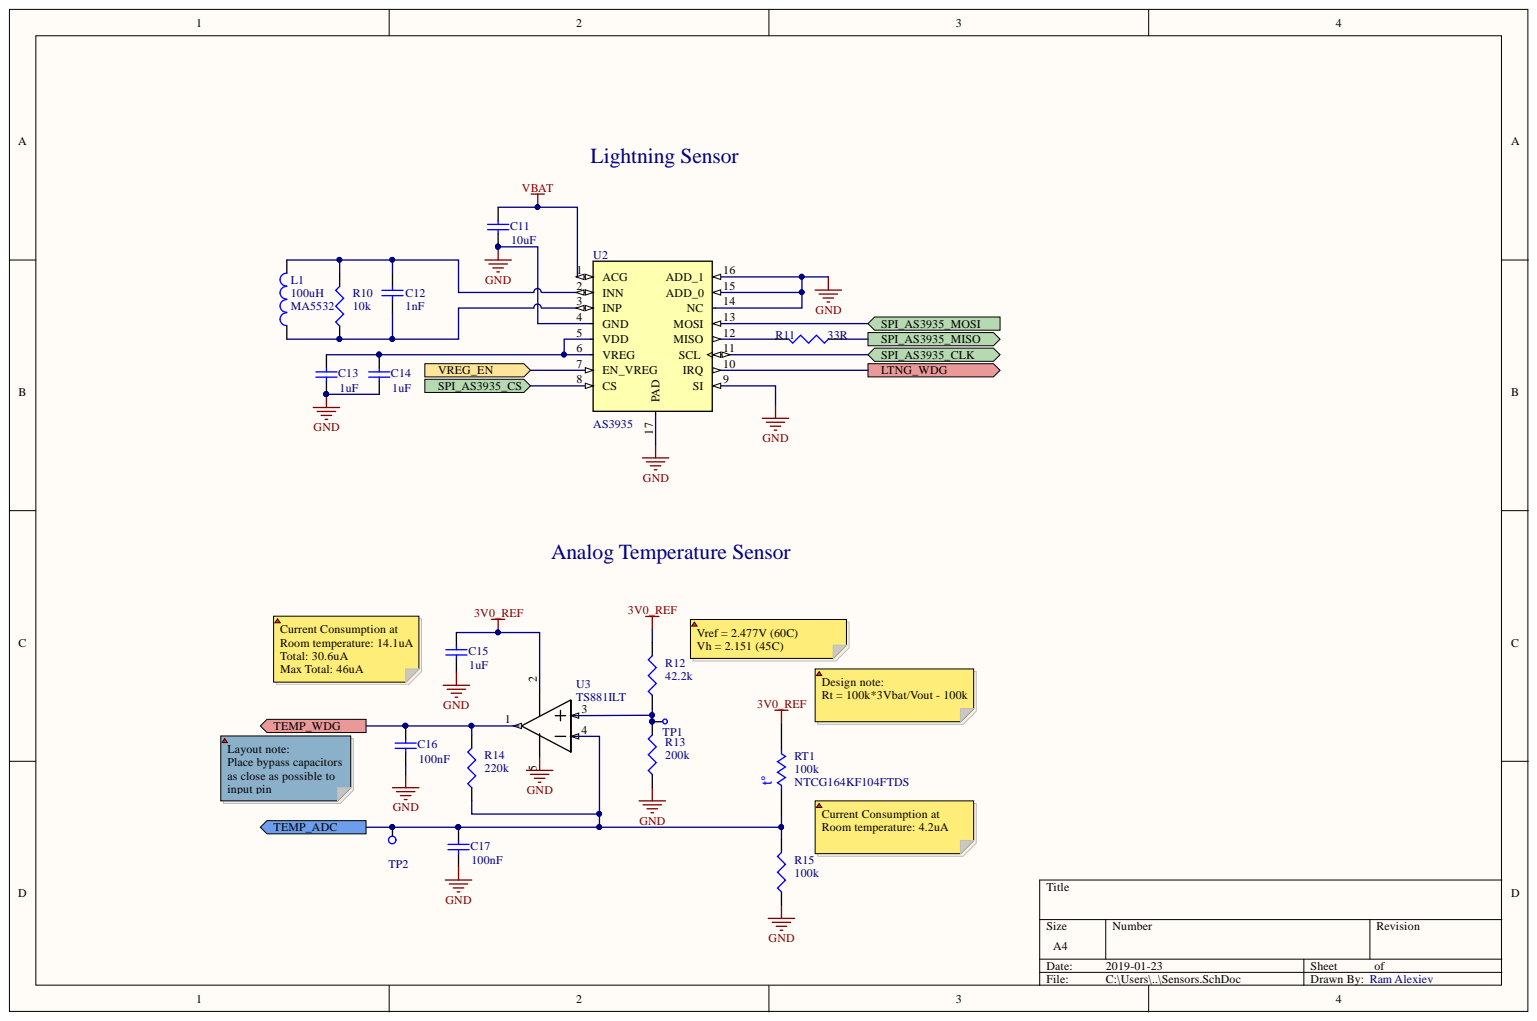
[picture p25: page 6]

Layout note:
Place bypass capacitors
as close as possible to
input pin
