ramalexiev/FireNet/Simulations/Analog Temperature Sensor/Varying Temperature.asc

C1: cap; 0.1µ; V=50
R4: res; 220k; tol=1
R5: res; 500k; tol=1
R12: res; 42.2k; tol=1
R13: res; 200k; tol=1
R15: res; 100k; tol=0.1
U1: xvaristor; B57452V5104J062
U3: LT1716
V1: voltage; 3V
Named nets: 0, +3V, Vcc, Vadc, Vref, Output
.SUBCKT B57452V5104J062 1 2  PARAMS: TOL=0
X1 1 2 NTC Params: 
+ B0=-16.4710190481099
+ B1=5162.00497681668
+ B2=63919.4570966831
+ B3=-53047574.22
+ B4=3478532052.4
+ R25=100000
+ T={1+TOL/100} 
+ CTH=0.035 GTH0=0.00246 GTH1=0 TK=273.15
.ENDS
.dc TEMP -40 150 1
.include ntc_20130313.lib
