ramalexiev/FireNet/(list of files, drawings)

Other design files:
FireNet Pod.PrjPcb
Main Platform/Rev1/R1_FireNet Pod.PrjPcb
Main Platform/Rev1/Schematics/R1_Block Diagram.SchDoc
Main Platform/Rev1/Schematics/R1_Debug.SchDoc
Main Platform/Rev1/Schematics/R1_LoRa Transceiver.SchDoc
Main Platform/Rev1/Schematics/R1_Microcontroller Interface.SchDoc
Main Platform/Rev1/Schematics/R1_Power Stage.SchDoc
Main Platform/Rev1/Schematics/R1_Sensors TempLightning.SchDoc
Main Platform/Rev2/R2_FireNet Pod.PrjPcb
Main Platform/Rev2/Schematics/R2_Block Diagram.SchDoc
Main Platform/Rev2/Schematics/R2_Debug.SchDoc
Main Platform/Rev2/Schematics/R2_LoRa Transceiver.SchDoc
Main Platform/Rev2/Schematics/R2_Microcontroller Interface.SchDoc
Main Platform/Rev2/Schematics/R2_Power Stage.SchDoc
Main Platform/Rev2/Schematics/R2_Sensors_TempLightning.SchDoc
Schematics/BME280.SchDoc
Schematics/Debug.SchDoc
Schematics/LoRa Transceiver.SchDoc
Schematics/Off-Board Sensors.SchDoc
Schematics/Power Stage.SchDoc
Schematics/Sensors.SchDoc
Sensor Board/Rev1/EmberNet Sensor Board.PrjPcb
Sensor Board/Rev1/Off-Board Sensors.SchDoc
Sensor Board/Rev1/Ram's Component Library.PcbLib
Sensor Board/Rev1/Ram's Schematics Libary.SchLib
Sensor Board/Rev1/Sensor Board.PcbDoc
Sensor Board/Rev2/R2_EmberNet Sensor Board.PrjPcb
Sensor Board/Rev2/R2_Off-Board Sensors.SchDoc
Sensor Board/Rev2/R2_Sensor Board.PcbDoc
Sensor Board/Rev2/Ram's Component Library.PcbLib
Sensor Board/Rev2/Ram's Schematics Libary.SchLib
