ramalexiev/FireNet/(commit log)

2018-10-14 Project Setup
    [BME280.SchDoc, Block Diagram.SchDoc, Microcontroller Interface.SchDoc, Power Stage.SchDoc]
2018-10-14 Structure setup
    [Block Diagram.SchDoc, FireNet Pod.PrjPcb]
2018-10-14 Adding Component Library
    [Ram's Schematics Libary.SchLib]
2018-10-14 Added Schematic Symbol for microcontroller
    [FireNet Pod.PrjPcb, Microcontroller Interface.SchDoc]
2018-10-14 Added RTC Crystal
    [Microcontroller Interface.SchDoc, Ram's Schematics Libary.SchLib]
2018-10-14 Added MCU Bypassing components
    [Microcontroller Interface.SchDoc]
2018-10-15 Added Thermistor circuit
    [Microcontroller Interface.SchDoc]
2018-10-22 Added serial debug interface connector
    [Microcontroller Interface.SchDoc, Ram's Schematics Libary.SchLib]
2018-10-22 Added TVS diode for serial interface
    [Microcontroller Interface.SchDoc, Ram's Schematics Libary.SchLib]
2018-10-22 Added BME280
    [BME280.SchDoc, Ram's Schematics Libary.SchLib]
2018-10-24 Added new component symbols and footprints from online sources snapeda
    [BME280.SchDoc, FireNet Pod.PrjPcb, Microcontroller Interface.SchDoc, Power Stage.SchDoc, Ram's Schematics Libary.SchLib]
2018-10-25 Changed values for Analog temperature sensor
    [BME280.SchDoc, FireNet Pod.PrjPcb, Power Stage.SchDoc, Ram's Schematics Libary.SchLib, Sensors.SchDoc]
2018-10-25 Added 3V Reference Rail
    [FireNet Pod.PrjPcb, LoRa Transceiver.SchDoc, Microcontroller Interface.SchDoc, Power Stage.SchDoc, Sensors.SchDoc]
2018-10-25 Added components related to LoRa Transceiver SX1272
    [FireNet Pod.PrjPcb, LoRa Transceiver.SchDoc, Ram's Schematics Libary.SchLib]
2018-10-25 prepare for presentation to Sanja and Fariborz
    [FireNet Pod.PrjPcb, LoRa Transceiver.SchDoc, Microcontroller Interface.SchDoc, Power Stage.SchDoc, Ram's Schematics Libary.SchLib, Sensors.SchDoc]
2018-10-25 Minor Edits
    [Microcontroller Interface.SchDoc]
2018-10-25 Annotated Schematics
    [LoRa Transceiver.SchDoc, Microcontroller Interface.SchDoc, Power Stage.SchDoc, Sensors.SchDoc]
2018-11-04 Added values for tuned RLC antenna on Lightning sensor
    [FireNet Pod.PrjPcb, Microcontroller Interface.SchDoc, Power Stage.SchDoc, Sensors.SchDoc]
2018-11-04 Added switch for sensors and 1V8 Driver for gas sensor
    [FireNet Pod.PrjPcb, Off-Board Sensors.SchDoc, Power Stage.SchDoc, Ram's Schematics Libary.SchLib, Sensors.SchDoc]
2018-11-14 Added level shifting circuitry, connector, and passives to Off-Board Sensors page
    [Microcontroller Interface.SchDoc, Off-Board Sensors.SchDoc, Power Stage.SchDoc, Ram's Schematics Libary.SchLib]
2018-11-14 Added debug schematic page
    [Debug.SchDoc]
2018-11-14 Added Debug shcematic page
    [FireNet Pod.PrjPcb]
2018-11-16 Added values for passives for RF transceiver
    [LoRa Transceiver.SchDoc, Sensors.SchDoc]
2018-11-16 Finishing touches on Mictrocontroller page
    -Added EMI series resistors
    -Annotated schematics
    -Assigned micro pins
    [Debug.SchDoc, LoRa Transceiver.SchDoc, Microcontroller Interface.SchDoc, Off-Board Sensors.SchDoc, Power Stage.SchDoc, Sensors.SchDoc]
2018-11-16 -Replaced 1V8 LDO with less-components part -General cleanup and successful compilation
    [Debug.SchDoc, FireNet Pod.PrjPcb, LoRa Transceiver.SchDoc, Microcontroller Interface.SchDoc, Off-Board Sensors.SchDoc, Power Stage.SchDoc, Ram's Schematics Libary.SchLib, Sensors.SchDoc]
2018-11-19 Changed Sensor switch and Voltage Reference
    [Debug.SchDoc, FireNet Pod.PrjPcb, LoRa Transceiver.SchDoc, Microcontroller Interface.SchDoc, Off-Board Sensors.SchDoc, Power Stage.SchDoc, Ram's Schematics Libary.SchLib]
2018-11-23 Added battery backup circuit
    [Debug.SchDoc, FireNet Pod.PrjPcb, LoRa Transceiver.SchDoc, Microcontroller Interface.SchDoc, Off-Board Sensors.SchDoc, Power Stage.SchDoc, Ram's Schematics Libary.SchLib]
2018-12-15 Updated footprints for components on Microcontroller schematic page
    [FireNet Pod.PrjPcb, LoRa Transceiver.SchDoc, Microcontroller Interface.SchDoc]
2018-12-15 Updated footprints on Transceiver schematic sheet
    [LoRa Transceiver.SchDoc]
2018-12-15 Updated footprints on Debug schematic sheet
    [Debug.SchDoc]
2018-12-15 Updated all component footprints, except AS3935 and connectors
    [LoRa Transceiver.SchDoc, Microcontroller Interface.SchDoc, Off-Board Sensors.SchDoc, Power Stage.SchDoc, Sensors.SchDoc]
2018-12-19 Changes for preliminary layout
    [Debug.SchDoc, FireNet Pod.PrjPcb, LoRa Transceiver.SchDoc, Microcontroller Interface.SchDoc, Off-Board Sensors.SchDoc, Power Stage.SchDoc, Ram's Schematics Libary.SchLib, Sensors.SchDoc]
2019-01-14 Main PCB ~done
2019-01-14 Shape for sensor platform drawn out
    [Debug.SchDoc, FireNet Pod.PrjPcb, LoRa Transceiver.SchDoc, Microcontroller Interface.SchDoc, Off-Board Sensors.SchDoc, Power Stage.SchDoc, Ram's Schematics Libary.SchLib, Sensors.SchDoc]
2019-02-22 Added BOMs
    [FireNet Pod - Altium.xlsx, FireNet Pod.xlsx, Updated Colective BOM.xlsx]
2019-02-22 MAIN PLATFORM FIRST BUILD
    [BOM.xls, R1_Block Diagram.SchDoc, R1_Debug.SchDoc, R1_FireNet Pod.PrjPcb, R1_LoRa Transceiver.SchDoc, R1_Microcontroller Interface.SchDoc, R1_Power Stage.SchDoc, R1_Sensors TempLightning.SchDoc]
2019-02-22 REV1 Sensor board FINAL
    [BOM.xls, EmberNet Sensor Board.PrjPcb, Off-Board Sensors.SchDoc, R2_EmberNet Sensor Board.PrjPcb, R2_Off-Board Sensors.SchDoc, R2_Sensor Board.PcbDoc, Ram's Component Library.PcbLib, Ram's Schematics Libary.SchLib]
2019-02-23 Fixed mistakes made on first revision
    [R2_Debug.SchDoc, R2_FireNet Pod.PrjPcb, R2_LoRa Transceiver.SchDoc, R2_Microcontroller Interface.SchDoc, R2_Power Stage.SchDoc, R2_Sensors_TempLightning.SchDoc]
2019-03-10 Preliminary Final R2 design
    [R2_Block Diagram.SchDoc, R2_Debug.SchDoc, R2_FireNet Pod.PrjPcb, R2_LoRa Transceiver.SchDoc, R2_Power Stage.SchDoc]
2019-03-13 FINAL LAYOUT OF REV02
    [R2_Debug.SchDoc, R2_LoRa Transceiver.SchDoc, R2_Microcontroller Interface.SchDoc, R2_Power Stage.SchDoc, R2_Sensors_TempLightning.SchDoc]
